MagnusHerrlin/Rpi4-4DmxOut/BottomView.jpg

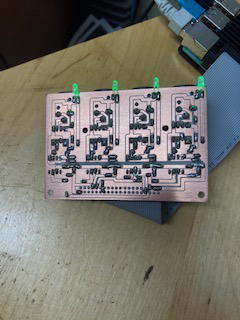
BottomView.jpg
