MagnusHerrlin/Rpi4-4DmxOut/4-Uni.jpg

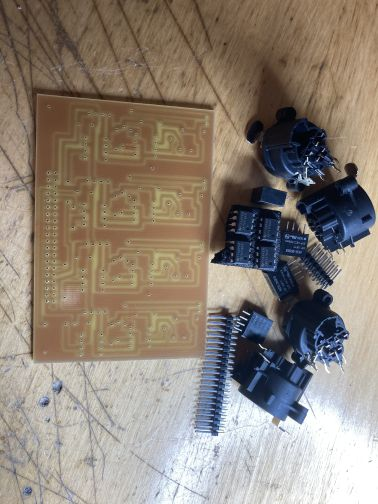
4-Uni.jpg
