MagnusHerrlin/Rpi4-4DmxOut/README.md

A prototype board to get four isolated dmx outputs from a raspberry pi 4
to use with ola https://github.com/OpenLightingProject/ola and the UART native DMX plugin.

I used Matthias Hertels design from here: http://mathertel.de/Arduino/DMXShield.aspx and modified it.
