MagnusHerrlin/Rpi4-4DmxOut/IMG_4783.jpg

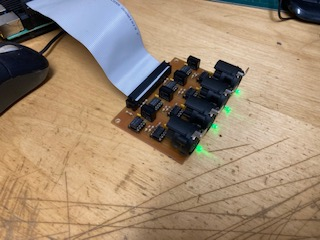
IMG_4783.jpg
