MagnusHerrlin/Rpi4-4DmxOut/4-UniverseOutV2.brd

## EAGLE design 4-UniverseOutV2.brd (2020-12-22)

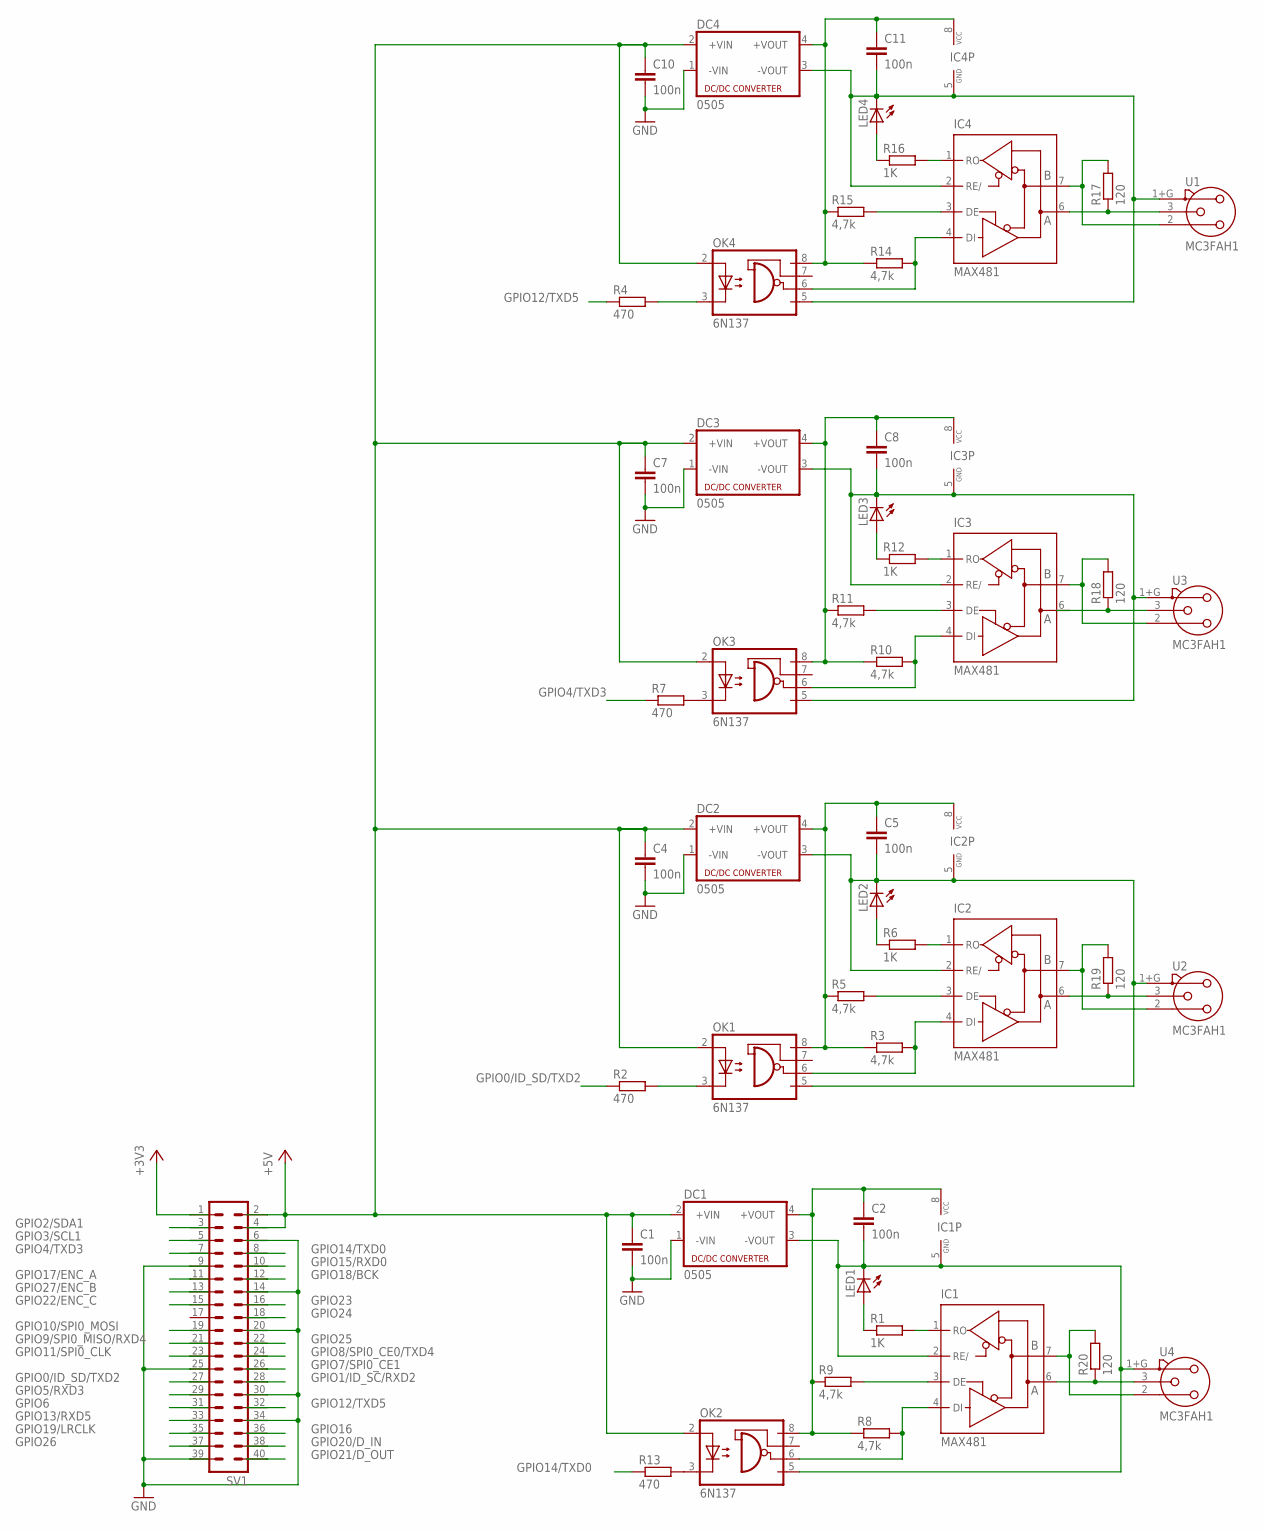
[picture p4: schematic 4-UniverseOutV2.sch]

Parts:
C1, C4, C7, C10: 100n; C5B3
C2, C5, C8, C11: 100n; C7.5B3
DC1, DC2, DC3, DC4: 0505; NME
IC1, IC2, IC3, IC4: MAX481; DIL08
LED1, LED2, LED3, LED4: LED3MM
OK1, OK2, OK3, OK4: 6N137; DIL08
R1, R6, R12, R16: 1K; 0204/7
R2, R4, R7, R13: 470; 0204/7
R3, R5, R8, R9, R10, R11, R14, R15: 4,7k; 0204/7
R17, R18, R19, R20: 120; 0207/2V
SV1: ML40
U1, U2, U3, U4: MC3FAH1; NC3FAH1

Connections:
+3V3: SV1.1
+5V: C1.1, C4.1, C7.1, C10.1, DC1.2 (+VIN), DC2.2 (+VIN), DC3.2 (+VIN), DC4.2 (+VIN), OK1.2 (A), OK2.2 (A), OK3.2 (A), OK4.2 (A), SV1.2, SV1.4
+5V_EXT: C2.1, DC1.4 (+VOUT), IC1.8 (VCC), OK2.8 (VCC), R8.1, R9.1
+5V_EXT1: C5.1, DC2.4 (+VOUT), IC2.8 (VCC), OK1.8 (VCC), R3.1, R5.1
+5V_EXT2: C8.1, DC3.4 (+VOUT), IC3.8 (VCC), OK3.8 (VCC), R10.1, R11.1
+5V_EXT3: C11.1, DC4.4 (+VOUT), IC4.8 (VCC), OK4.8 (VCC), R14.1, R15.1
GND: C1.2, C4.2, C7.2, C10.2, DC1.1 (-VIN), DC2.1 (-VIN), DC3.1 (-VIN), DC4.1 (-VIN), SV1.6, SV1.9, SV1.14, SV1.20, SV1.25, SV1.30, SV1.34, SV1.39
GND_EXT: C2.2, DC1.3 (-VOUT), IC1.2 (RE/), IC1.5 (GND), LED1.K (C), OK2.5 (GND), U4.1+G (1)
GND_EXT1: C5.2, DC2.3 (-VOUT), IC2.2 (RE/), IC2.5 (GND), LED2.K (C), OK1.5 (GND), U2.1+G (1)
GND_EXT2: C8.2, DC3.3 (-VOUT), IC3.2 (RE/), IC3.5 (GND), LED3.K (C), OK3.5 (GND), U3.1+G (1)
GND_EXT3: C11.2, DC4.3 (-VOUT), IC4.2 (RE/), IC4.5 (GND), LED4.K (C), OK4.5 (GND), U1.1+G (1)
GPIO0/ID_SD/TXD2: R2.1, SV1.27
GPIO1/ID_SC/RXD2: SV1.28
GPIO2/SDA1: SV1.3
GPIO3/SCL1: SV1.5
GPIO4/TXD3: R7.1, SV1.7
GPIO5/RXD3: SV1.29
GPIO6: SV1.31
GPIO7/SPI0_CE1: SV1.26
GPIO8/SPI0_CE0/TXD4: SV1.24
GPIO9/SPI0_MISO/RXD4: SV1.21
GPIO10/SPI0_MOSI: SV1.19
GPIO11/SPI0_CLK: SV1.23
GPIO12/TXD5: R4.1, SV1.32
GPIO13/RXD5: SV1.33
GPIO14/TXD0: R13.1, SV1.8
GPIO15/RXD0: SV1.10
GPIO16: SV1.36
GPIO17/ENC_A: SV1.11
GPIO18/BCK: SV1.12
GPIO19/LRCLK: SV1.35
GPIO20/D_IN: SV1.38
GPIO21/D_OUT: SV1.40
GPIO22/ENC_C: SV1.15
GPIO23: SV1.16
GPIO24: SV1.18
GPIO25: SV1.22
GPIO26: SV1.37
GPIO27/ENC_B: SV1.13
unnamed: OK4.3 (C), R4.2
unnamed: OK3.3 (C), R7.2
unnamed: OK1.3 (C), R2.2
unnamed: OK2.3 (C), R13.2
unnamed: IC1.3 (DE), R9.2
unnamed: IC1.4 (DI), OK2.6 (VO), R8.2
unnamed: IC1.6 (A), R20.1, U4.3
unnamed: IC1.7 (B), R20.2, U4.2
unnamed: IC1.1 (RO), R1.2
unnamed: LED1.A, R1.1
unnamed: IC2.3 (DE), R5.2
unnamed: IC2.4 (DI), OK1.6 (VO), R3.2
unnamed: IC2.6 (A), R19.1, U2.3
unnamed: IC2.7 (B), R19.2, U2.2
unnamed: IC2.1 (RO), R6.2
unnamed: LED2.A, R6.1
unnamed: IC3.3 (DE), R11.2
unnamed: IC3.4 (DI), OK3.6 (VO), R10.2
unnamed: IC3.6 (A), R18.1, U3.3
unnamed: IC3.7 (B), R18.2, U3.2
unnamed: IC3.1 (RO), R12.2
unnamed: LED3.A, R12.1
unnamed: IC4.3 (DE), R15.2
unnamed: IC4.4 (DI), OK4.6 (VO), R14.2
unnamed: IC4.6 (A), R17.1, U1.3
unnamed: IC4.7 (B), R17.2, U1.2
unnamed: IC4.1 (RO), R16.2
unnamed: LED4.A, R16.1

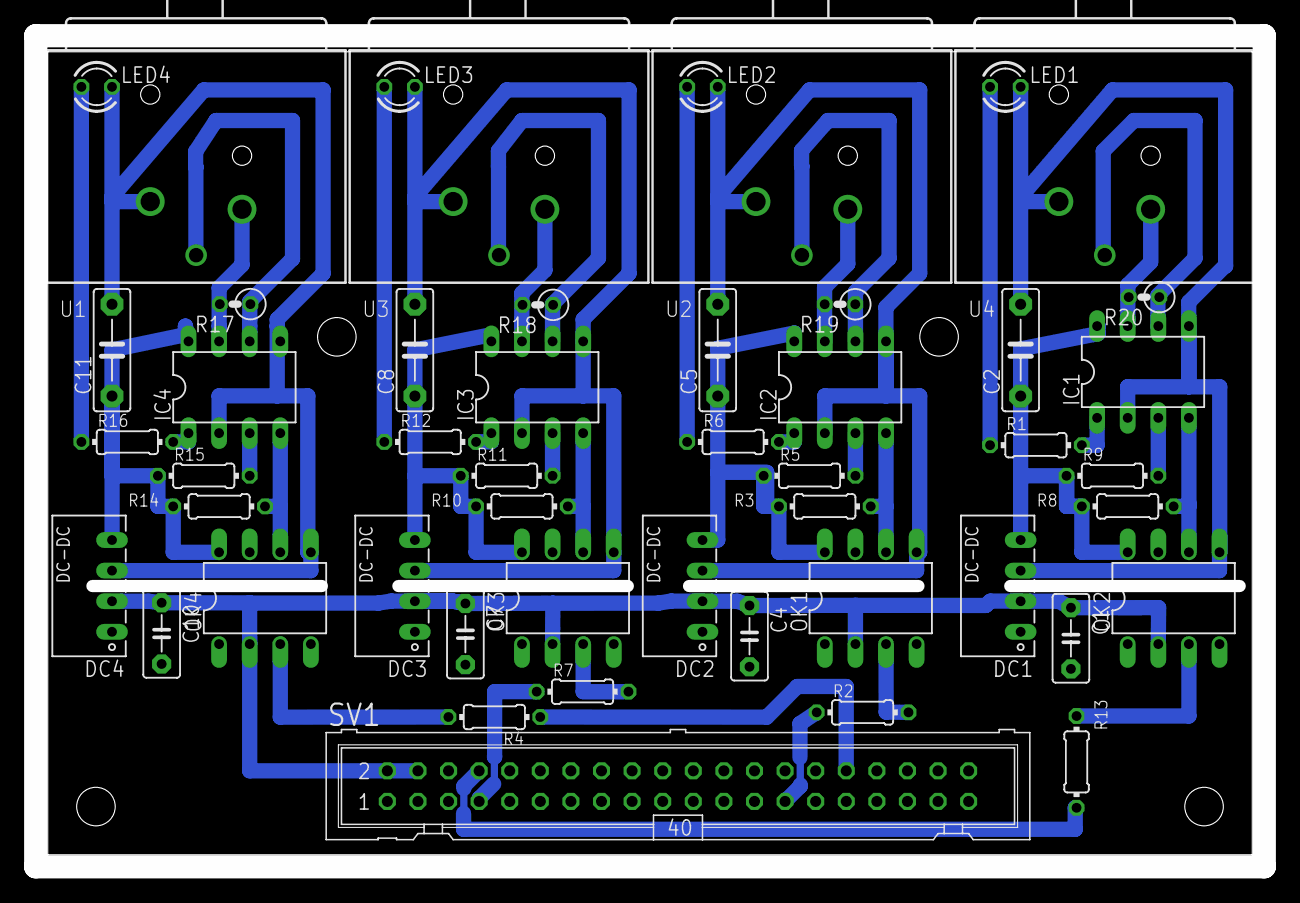
[picture p5: board 4-UniverseOutV2.brd from above]

Board: 2 copper layers, 102.0 x 69.0 mm, 49 parts (0 on the bottom side), 42 nets.
