MagnusHerrlin/Rpi4-4DmxOut/(commit log)

2020-12-22 Create ola-uartdmx.conf
    Replace /etc/ola/ola-uartdmx.conf with this to enable RPI4 extra uarts
2020-12-22 Add files via upload
    Added 120ohm resistors
    [4-UniverseOutV2.brd, 4-UniverseOutV2.sch]
